alexanderjessethomas/Arduino-Team-Bam/(commit log)

2017-07-14 Final Arduino Code for Capstone
    These arduino sketches were written for an Arduino Uno. The bluetooth module used was an hc-08 and an hm-10. The motor controllers used for this project are Cytron MD10C revision 3. The childs car that this system was used for was a Spin & Go Extreme
2017-07-25 Added How-To Document
    This was a document created for the capstone project so people could recreate what we created. This goes through mounting hardware to the ride on toy car, flashing the code to the arduino, configuring bluetooth, nd using the mobile application.
2017-07-28 PDF version of the presentation
    This is a presentation that was used for Spring 2017 NAU Ugrads for Team B.A.M. from the computer science department. Ugrads is an even at NAU where capstone teams present their projects infront of an audience, anyone is allowed to attend. My capstone team was judge by an mechanical engineering professor for the presentation. Our over all Ugrads score was a 4.6 out of 5. This score was the poster score and this presentation score combined.
2017-07-28 Powerpoint used for Ugrads presentation
2017-07-28 Link to Google Drive Powerpoint Folder
